vitaliy2034/KPI-Analog-Course-Work/Documentation/Kursach.odt

НАЦІОНАЛЬНИЙ ТЕХНІЧНИЙ УНІВЕРСИТЕТ УКРАЇНИ

«КИЇВСЬКИЙ ПОЛІТЕХНІЧНИЙ ІНСТИТУТ»

Кафедра конструювання електронно-обчислювальної апаратури

КУРСОВА РОБОТА

з дисципліни Схемотехніка аналогової та цифрової радіоелектронної апаратури

на тему: Трансформаторний перетворювач напруги 12-400V

Студента 2 курсу групи ДК-82

Напряму підготовки: Радіоелектронні апарати

Спеціальності: Радіоелектронні апарати та засоби

Білий В.О.

Керівник:

____________________________________

(посада, вчене звання, науковий ступінь, прізвище та ініціали)

Національна оцінка: ________________

Кількість балів: ____ Оцінка: ECTS _____

Члени комісії: _____________ ___ст. викл., к.т.н. Короткий Є.В.___

(підпис) (вчене звання, науковий ступінь, прізвище та ініціали)

_____________ _________________________________

(підпис) (вчене звання, науковий ступінь, прізвище та ініціали)

Київ - 2020 рік
