vitaliy2034/KPI-Analog-Course-Work/Simulation/FullSchematics.asc

C1: cap; 10n
C2: cap; 0.1µ
C3: cap; 1n
C4: cap; 1n
C5: cap; 1n
D1: diode; 1N4007
D2: diode; 1N4007
D3: diode; 1N4007
D4: diode; 1N4007
D5: schottky; 1N5817
D6: zener; PH_PDZ5.6B
D7: schottky; 1N5817
D8: zener; PH_PDZ5.6B
D9: diode; 1N4007
D10: diode; 1N4007
D11: diode; 1N4007
L1: ind2; 14m; Rser=0.3
L2: ind2; 4; Rser=0
L3: ind2; 14m; Rser=0.3
Q1: npn; 2N2222
Q2: npn; 2N2222
Q3: pnp; BCW68G
Q4: pnp; BCW68G
Q5: npn; 2sc945
R1: res; 1k
R2: res; 1k
R3: res; 1k
R4: res; 1k
R5: res; 4
R6: res; 10k
R7: res; 10k
R8: res; 10
R9: res; 2.5k
R10: res; 10
R11: res; 4
R12: res; 2.5k
R13: res; 10k
R14: res; 1k
R15: res; 10k
R16: res; 1k
R17: res; 100k
R18: res; 10k
U1: 555
U2: irfp350
U3: irf540n
U4: lm393
U5: lm393
V1: voltage; PULSE(0 12 5u 0.001n 0.001n 1 1)
Named nets: VCC, 0, HV-, HV+, Vfd
.tran 0 1.2m 1m 100n
K1 L1 L3 L2 1
Deat time part
NE555 out Amplifier
NE555 out Amplifier
Push-Pull Transformer and  Power MOSFETs
NE555 clock generator
Deat time, inverter part
Vfd connection
