vitaliy2034/KPI-Analog-Course-Work/Simulation/Draft2.asc

L1: ind2; 13m
V1: voltage; PULSE(0 12 0 0.0001u 0.0001u 8.33u 16.66u)
Named nets: 0
.tran 0.1m
