vitaliy2034/KPI-Analog-Course-Work/Simulation/Draft3.asc

Q1: npn
R1: res
R2: res; 1k
R3: res
R4: res
U1: pc357nt
V1: voltage
V2: voltage
Named nets: 0
